cbm-instructions/creative-visions/images/creative-visions/Verschaltung.jpg

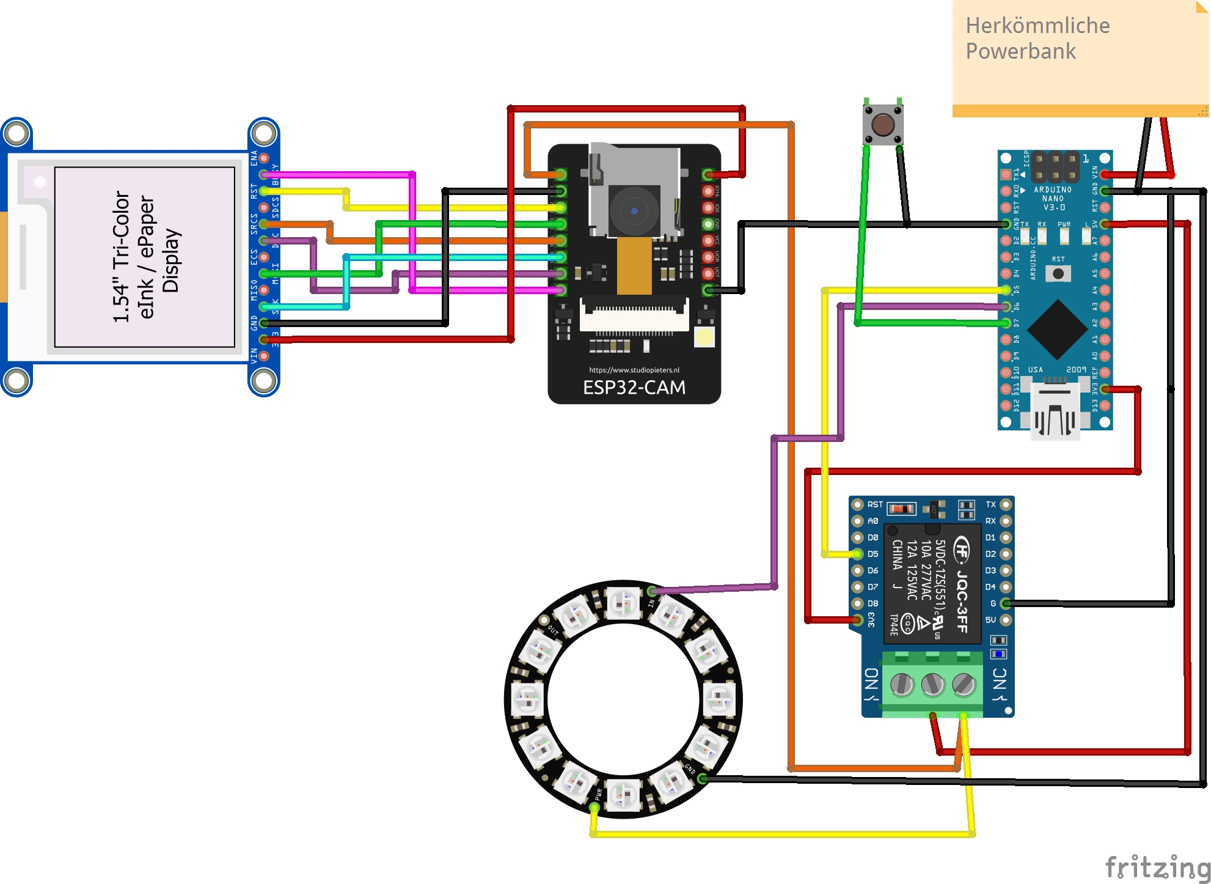
images/creative-visions/Verschaltung.jpg
