cbm-instructions/creative-visions/(commit log)

2023-02-01 Add ESP32-CAM code
2023-02-01 Add Arduino-Nano code
2023-02-02 Funktionsweise wirklich DONE
